draw-four/UMD_Solar_Gamera_Avionics/PCB/Motherboard/Solar_Gamera_HQ.png

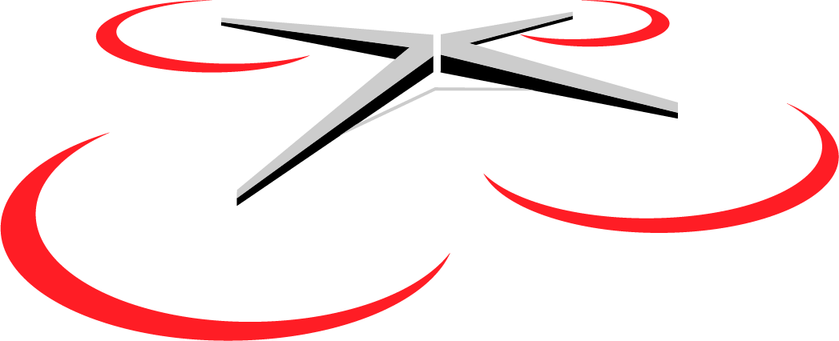
PCB/Motherboard/Solar_Gamera_HQ.png
