draw-four/UMD_Solar_Gamera_Avionics/PCB/Motherboard/3D Models/raspberry pi pico.step

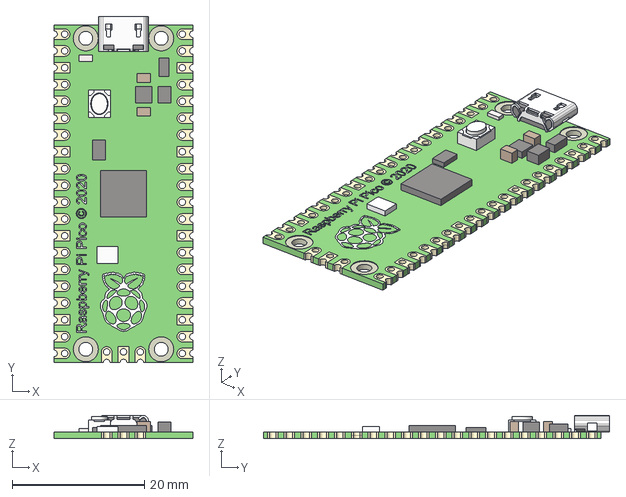
[picture p2: CAD file, 2025-11-19]
PCB/Motherboard/3D Models/raspberry pi pico.step
21.0 x 52.3 x 3.50 mm
