draw-four/UMD_Solar_Gamera_Avionics/PCB/Motherboard/3D Models/2445P Screw Terminal Block- 2 Pin, 3.5mm Pitch, Side Entry.STEP

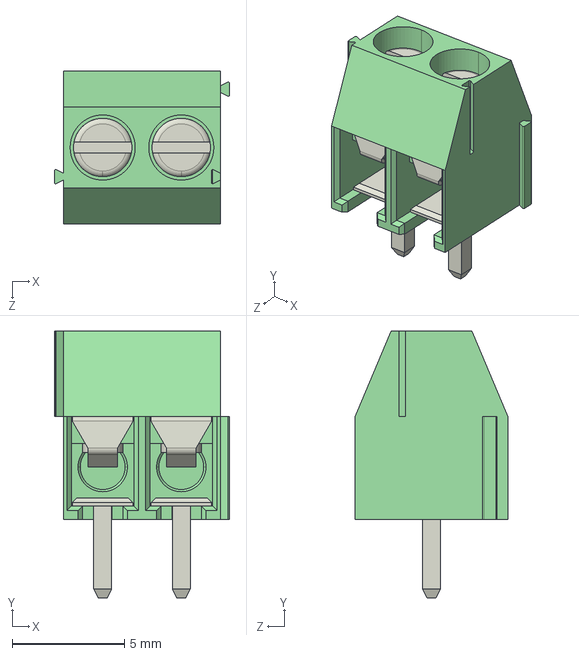
[picture p3: CAD file, 2025-11-19]
PCB/Motherboard/3D Models/2445P Screw Terminal Block- 2 Pin, 3.5mm Pitch, Side Entry.STEP
7.80 x 11.9 x 6.80 mm
