draw-four/UMD_Solar_Gamera_Avionics/PCB/Motherboard/3D Models/EL90124--TSD--Logic Level Converter.STEP

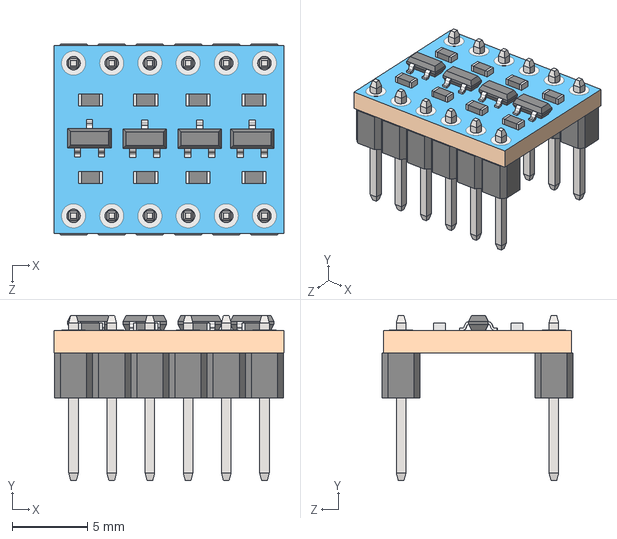
[picture p4: CAD file, 2025-11-19]
PCB/Motherboard/3D Models/EL90124--TSD--Logic Level Converter.STEP
15.3 x 11.0 x 12.7 mm
