draw-four/UMD_Solar_Gamera_Avionics/PCB/Motherboard/Motherboard.kicad_pcb

## KiCad design PCB/Motherboard/Motherboard.kicad_pcb (2025-11-19)

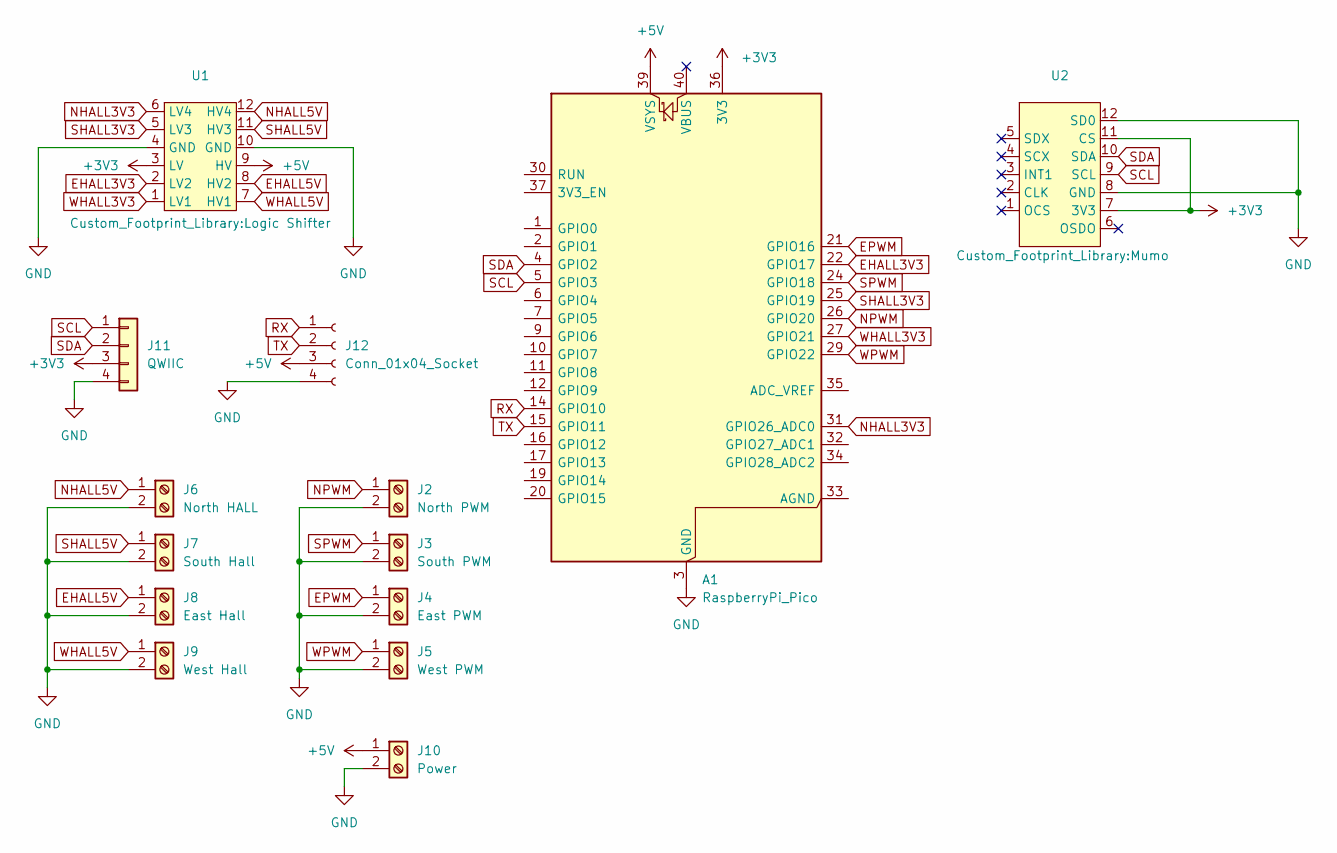
[picture p5: schematic Motherboard.kicad_sch]

Parts:
A1: RaspberryPi_Pico; RaspberryPi_Pico_Common_THT
J2: North PWM; TerminalBlock_4Ucon_1x02_P3.50mm_Vertical
J3: South PWM; TerminalBlock_4Ucon_1x02_P3.50mm_Vertical
J4: East PWM; TerminalBlock_4Ucon_1x02_P3.50mm_Vertical
J5: West PWM; TerminalBlock_4Ucon_1x02_P3.50mm_Vertical
J6: North HALL; TerminalBlock_4Ucon_1x02_P3.50mm_Vertical
J7: South Hall; TerminalBlock_4Ucon_1x02_P3.50mm_Vertical
J8: East Hall; TerminalBlock_4Ucon_1x02_P3.50mm_Vertical
J9: West Hall; TerminalBlock_4Ucon_1x02_P3.50mm_Vertical
J10: Power; TerminalBlock_4Ucon_1x02_P3.50mm_Vertical
J11: QWIIC; JST_PH_B4B-PH-K_1x04_P2.00mm_Vertical
J12: Conn_01x04_Socket; PinHeader_1x04_P2.54mm_Vertical
U1: Logic Shifter
U2: Mumo

Connections:
+3V3: A1.36 (3V3), J11.3, U1.3 (LV), U2.7 (3V3), U2.11 (CS)
+5V: A1.39 (VSYS), J10.1, J12.3, U1.9 (HV)
EHALL3V3: A1.22 (GPIO17), U1.2 (LV2)
EHALL5V: J8.1, U1.8 (HV2)
EPWM: A1.21 (GPIO16), J4.1
GND: A1.3 (GND), A1.8 (GND), A1.13 (GND), A1.18 (GND), A1.23 (GND), A1.28 (GND), A1.38 (GND), J2.2, J3.2, J4.2, J5.2, J6.2, J7.2, J8.2, J9.2, J10.2, J11.4, J12.4, U1.4 (GND), U1.10 (GND), U2.8 (GND), U2.12 (SD0)
NHALL3V3: A1.31 (GPIO26_ADC0), U1.6 (LV4)
NHALL5V: J6.1, U1.12 (HV4)
NPWM: A1.26 (GPIO20), J2.1
RX: A1.14 (GPIO10), J12.1
SCL: A1.5 (GPIO3), J11.1, U2.9 (SCL)
SDA: A1.4 (GPIO2), J11.2, U2.10 (SDA)
SHALL3V3: A1.25 (GPIO19), U1.5 (LV3)
SHALL5V: J7.1, U1.11 (HV3)
SPWM: A1.24 (GPIO18), J3.1
TX: A1.15 (GPIO11), J12.2
WHALL3V3: A1.27 (GPIO21), U1.1 (LV1)
WHALL5V: J9.1, U1.7 (HV1)
WPWM: A1.29 (GPIO22), J5.1

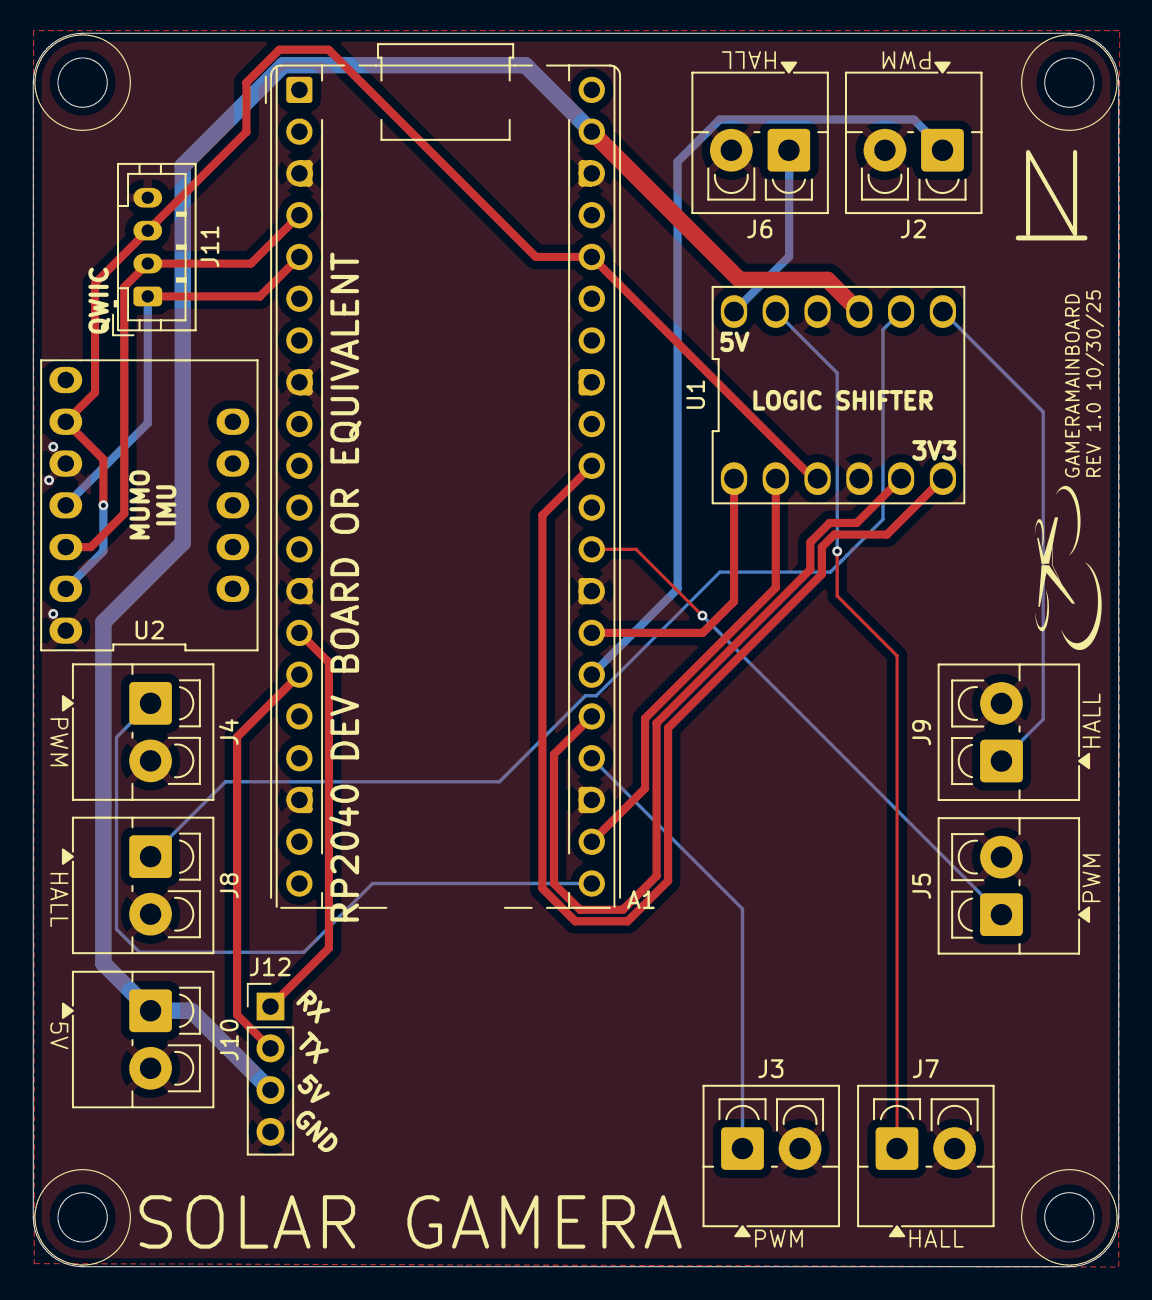
[picture p6: board Motherboard.kicad_pcb from above]

Board: 2 copper layers, 66.0 x 75.0 mm, 14 parts (0 on the bottom side), 19 nets.
