draw-four/UMD_Solar_Gamera_Avionics/PCB/Daughterboard/Daughterboard.kicad_pcb

## KiCad design PCB/Daughterboard/Daughterboard.kicad_pcb (2025-11-19)

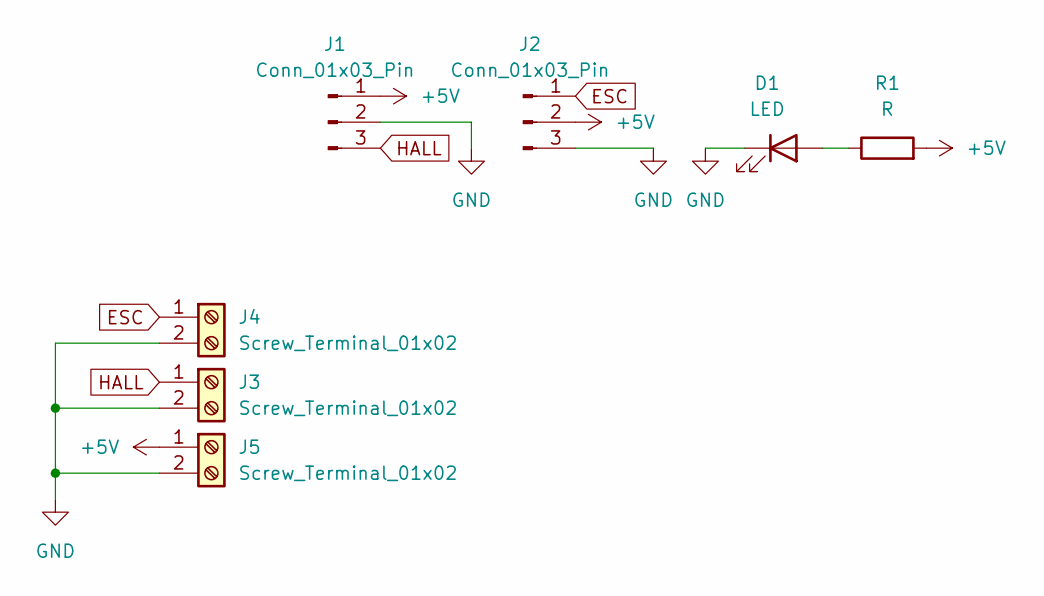
[picture p7: schematic Daughterboard.kicad_sch]

Parts:
D1: LED; LED_D5.0mm
J1, J2: Conn_01x03_Pin; PinSocket_1x03_P2.54mm_Vertical
J3, J4, J5: Screw_Terminal_01x02; TerminalBlock_4Ucon_1x02_P3.50mm_Vertical
R1: R; R_Axial_DIN0207_L6.3mm_D2.5mm_P7.62mm_Horizontal

Connections:
+5V: J1.1, J2.2, J5.1, R1.2
ESC: J2.1, J4.1
GND: D1.1 (K), J1.2, J2.3, J3.2, J4.2, J5.2
HALL: J1.3, J3.1
unnamed: D1.2 (A), R1.1

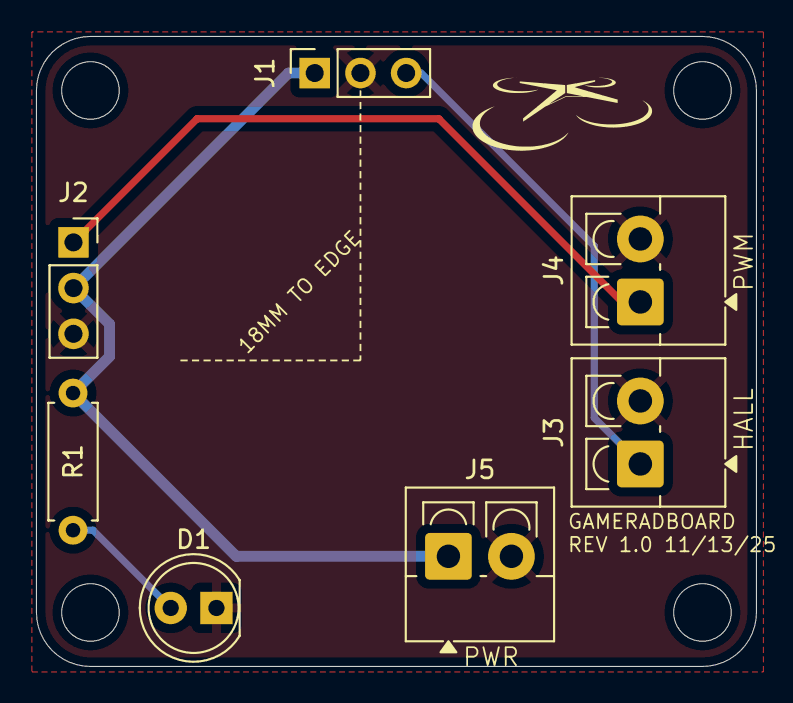
[picture p8: board Daughterboard.kicad_pcb from above]

Board: 2 copper layers, 40.0 x 35.0 mm, 7 parts (0 on the bottom side), 5 nets.
