draw-four/UMD_Solar_Gamera_Avionics/(threads)

Thread 1 (2025-02-12):

Create more streamlined input method

draw-four, 2025-02-12:
Our options include a joystick, some other HID or refactoring the keyboard input for ease of use.
The joystick is the hardest but most promising option. The main hurdle is porting the analog signals of a joystick to a four motor device. For example, the joystick might transmit 60 out of 360 indicating an angle of $`\frac{\pi}{3}`$ radians, indicating that the ratio of motor output between `X+` to `Y+` ought to be $`\sqrt{3}`$:1 and scaled accordingly. This might be implemented with a simple trig check every tick of flight time.
Potential issues:
How fast does this have to adjust (saw numbers of 20ms in the python code)? Need to adjust speed to percentages of baudrate
Will this scale to the other desired functions such as calibrate/full throttle? Seems likely
How important is omnidirectional flight anyway? Main concerns being full hover and forward lift

Closed 2025-03-10.

Thread 2 (2025-02-13):

Determine Hall effect sensor sensitivity & motor sensitivity

draw-four, 2025-02-13:
In-meeting

draw-four, 2025-02-13:
1. Adjust baud rate of Hall Sensor code
2. measure RPM

draw-four, 2025-02-18:
Potential problem: monitor needs to be reset after a lot of readings

draw-four, 2025-02-18:
FINDINGS:
Motor A clean, 1070 for 1070
Motor B iffy, +-40 rpm possibly due to a screw spinning near it
Motor C okish, +-10-20 drifting values due to vibrations.

draw-four, 2025-02-18:
Work in Serial.flush() for testing or open serial plotter.
Hall effect sensor confirmed working!

draw-four, 2025-03-10:
#8 Keep a close eye on print statements for RPM and Motor power and compare.

draw-four, 2025-03-12:
FINDINGS:
RPM sensing not working in new code, but the sensor physically works with original hallsensorcode.
Possibly due to baud rate; when introduce to 115200 baud rate the hall effect sensor code did not work (unicode special characters), while the 9600 hybrid code and ran keyboard python script the arduino_side code was unable to sync.
Hall effect sensor part number: Gikfun a3144/OH3144 EX1325

draw-four, 2025-04-08:
#12 closed at last!
Test #14 specifically with regards to RPM curve and latency.

Thread 5 (2025-02-18):

Create auto stabilizing motor code

draw-four, 2025-02-18:
Now that the sensors are confirmed to be working, design and implement code that ensures all motor RPM are
1. within acceptable parameters,
2. the same,
3. the desired RPM.
4.

draw-four, 2025-02-22:
Code created under hall-sensor-branch

draw-four, 2025-03-10:
All that remains is to test it and do a lot of debugging

Closed 2025-03-10.

Thread 6 (2025-02-20):

Wires messed up

draw-four, 2025-02-20:
Problem: Motor works but directional wires appear to be malfunctioning.
W wire is fried, no calibration
S wire works with the W key
Unlabeled wire 1 fried no calibration
Unlabeled wire 2 calibrated, works with the D key.

With old code everything is the same.

Possible solution check soldering of the pins and multimeter check the wires.

draw-four, 2025-02-25:
Found two unconnected wires ends, switching to the UNO to resolder all connections

draw-four, 2025-02-26:
All motors are GREEN :]

Closed 2025-02-26.

Thread 8 (2025-02-22):

Test new motor code

draw-four, 2025-02-22:
No joystick support

draw-four, 2025-02-25:
Identified one major issues (w/Rahul):
Hall Sensor "micros()" possibly designed to be running within the loop and not called in a case statement, therefore rewrite the code to either execute stabilizing unconditionally per loop or timed every 3 seconds.
Made one major change (not yet pushed): changed all relevant instances of 4 to NUMBER_OF_MOTORS.

draw-four, 2025-03-10:
Test code Iteration 1:
Automatically bumps up the motor power BY THE DIFFERENCE BETWEEN MEASURED RPM AND POWER, and does not bump up if this correction value is less than 10 or motor power would exceed min/max limits.

draw-four, 2025-03-10:
Main issues:
What is the ratio between motor power value to RPM? Assumed to be 1.

draw-four, 2025-03-25:
OPTIMIZED ARDUINO + HALL DOES NOT WORK, likely due to constant reads hanging cnt increment for hall effect sensor. Opened new issue in light of this.

draw-four, 2025-04-08:
#12 finally closed. Now to test the motor code (after fixing calibration) in light of combined code working.

draw-four, 2025-04-16:
Before tonight's meeting: 2 sensors + motor code working

draw-four, 2025-04-24:
Before tonight's meeting: 3 sensors (extra nano every) + motor code working
Calibration function is fixed! First Press c, then the tone should be heard, then power cycle, then another tone should be heard.
FOR NEXT MEETING:
Discuss how to power all four Arduinos (DUE powering all four? USB Bank?)
Discuss how to attach magnets and hall effect sensors to the aircraft.

draw-four, 2025-05-06:
Before tonight's meeting: Arduino power problem fixed, wires order should be placed soon. Magnet placement should be settled, still unsure about sensor arduinos.

draw-four, 2025-05-13:
4 SENSORS WORKING!
Implement and test on Gamera!

RrGhost23, 2025-09-13:
New speed controller connects to S, activates around 875.

Thread 9 (2025-02-27):

MOTOR ENSEMBLE works for 3 out of 4 motors

draw-four, 2025-02-27:
1. Tested speed controller
2. Switched port of power distribution board
3. Disconnected all of the other motors
4. Connected directly to power supply
5. Testing different motors...

Somehow three out of four motors would work but one motor with it or individually just doesn't seem to work bruh

draw-four, 2025-02-27:
LMAO it was a floating GND pin

Closed 2025-02-27.

Thread 10 (2025-03-06):

QUARTER ASSEMBLY INSTRUCTIONS

draw-four, 2025-03-06:
small triple wire: black to dark orange of motor.
two thick wires: match colors

white to 11 light purple to 10 green to 9 yellow to 6 red and black to 5V and GND

steps of motors to follow

draw-four, 2025-03-06:
pip install pyserial and numpy
before pressing c power must be DISCONNECTED
after plug in and calibration beep if no beep don't do anything
otherwise press key
c plug in beep key beep power cycle beep

Closed 2025-03-25.

Thread 11 (2025-03-10):

Testing motors reaction to voltage instability

draw-four, 2025-03-10:
Estimated worst case: 15V.
Base Case: 20.08V

Eyeballing it, when hall sensors are soldered test actual RPM change.

Base Case: All beeps green, slight delay when accelerating, constant hum.
Worst Case: All beeps green, slight delay, NOTICEABLY SLOWER, FLUCTUATES WITH VOLTAGE FLUCTUATIONS

#8 is gonna be way more important if solar panel voltage instability manifests during test

draw-four, 2025-03-25:
Quarter assembly complete; even with some faulty solar panels still behaves as expected!

Closed 2025-03-25.

Thread 12 (2025-03-25):

REFACTOR optimized arduino + hall effect sensor code

draw-four, 2025-03-25:
Tested with @RrGhost23, under #8. Sensor code does not work, only displays zeroes and does not loop but prints a bunch whenever key is pressed. Suspect Serial.read key buffer is hanging the sensor detection somehow and affecting the cnt.
Solution 1: Two Arduinos connected with SoftwareSerial.
Solution 2 (mine): implement basic scheduling by allowing readkey only after timeout of 1-2s.

draw-four, 2025-03-27:
Things to do:
flush serial after instantiation
add a variable delay (100)

draw-four, 2025-04-04:
Findings: non-blocking read hangs program or has same issue that hangs after few seconds (serial maxxed out)
Will be pivoting towards DUE hardware serial ports, because nano only has 2 interrupt pins.
Research: Both Hardware and SoftwareSerial

@RrGhost23 LET'S GO I GOT IT TO TRANSMIT DATA!!! CHECK THE NEW DUE-TESTING BRANCH!

draw-four, 2025-04-08:
@RrGhost23 BIG NEWS: **Got a fully working, float-type RPM measurement** that works independently of motor display. Only problem is calibration process may be a bit broken, we'll need to fix that tomorrow.
At long last, we can move on!

Closed 2025-04-08.

Thread 14 (2025-04-08):

Potential and latent issues with the new combined sensor+motor code

draw-four, 2025-04-08:
Potential problems:
1. Only 3 HardwareSerials possible. Could we have the last one work off of Software Serial, now that the problems of blocking read have been fixed (see DUE-testing arduino_side).
2. Sensor outputting RPM slowly so that motor must adjust speed slowly. Noticed latency in hall effect sensor.

draw-four, 2025-04-28:
New speed controller has a minimum of roughly 1200. Shuts off at 1190.

draw-four, 2025-04-29:
SoftwareSerial does NOT WORK with the Due... @RrGhost23 is modifying the HallEffectSensorCode to work with two sensors at once and format them and send them down the serial line such that the DUE will only need two HardwareSerial ports.

draw-four, 2025-05-06:
SDA/STL may work (I2C protocol too complex, logic level shifter required for cross comms)
Two sensors at once stubbornly refuses to work, best I could do (unstable) was have one give a reading then the second alternating.
Wednesday test will involve the last HardwareSerial in the DUE, handling the value as 'R<float>' from a modified hall effect sensor code.
If that doesn't work, get the Mega and try to get two sensors working at once. If not, we're working with three sensors.

draw-four, 2025-05-08:
Wednesday test did not work, baud rate issues (again). @RrGhost23 had the idea of using the nano every as the one to communicate with the last 115200 serial because it was able to read the sensor properly at that baud rate, but communication between it and the DUE were garbled. After hours I attempted to get it to work with Serial1, but results are inconclusive since I accidentally broke one of the wires on it.

draw-four, 2025-05-13:
4 SENSORS WORKING!
#8 Right now the Nano Every requires USB power, fix this during implementation
